GavinGY/MotorMF_AI/FAN_Test/Test.jpg

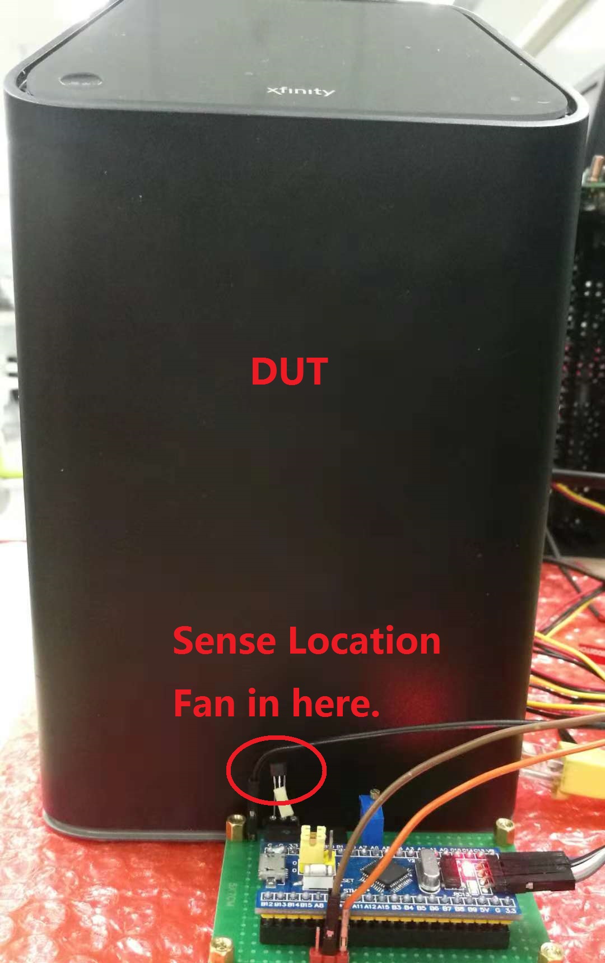
FAN_Test/Test.jpg
