GavinGY/MotorMF_AI/FAN_Test/Equipment.PNG

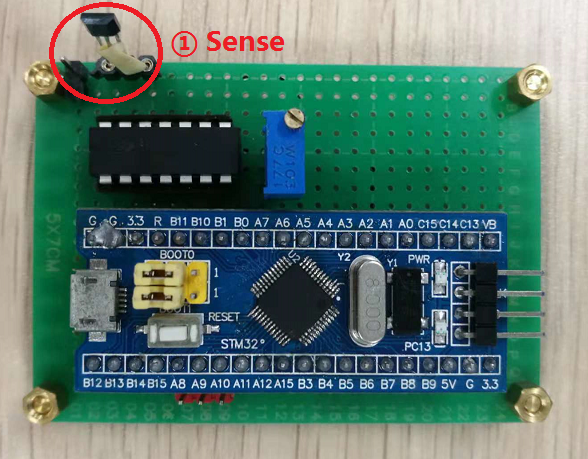
FAN_Test/Equipment.PNG
