GavinGY/MotorMF_AI/README.md

# MotorMF_AI
Motor magnetic field detection &amp;&amp; Edge of computing
