GavinGY/MotorMF_AI/FAN_Test/MagneticFieldDetection_BOM.xlsx

Comment | Description | Designator | Footprint | LibRef | Quantity | Value
Red LED | Typical INFRARED GaAs LED | D1 | LED-Red | LED | 1 | Red
AM3503 | Header, 3-Pin | P1 | HDR1X3 | AM3503 | 1 | AM3503
Power-IN | Header, 2-Pin | P2 | HDR1X2 | Header 2 | 1
UART | Header, 4-Pin, Right Angle | P3 | HDR1X4H | Header 4H | 1
Res Tap | Tapped Resistor | R1 | VR3 | Res Tap | 1 | 10K
Res Semi | Semiconductor Resistor | R2 | AXIAL-0.5 | Res Semi | 1 | 390R
Res Semi | Semiconductor Resistor | R3 | AXIAL-0.5 | Res Semi | 1 | 100K
Res Semi | Semiconductor Resistor | R4 | AXIAL-0.3 | Res1 | 1 | 510R
STM32F103C8T6_CoreBoard | MCU Core Board | U1 | DIP40 | STM32F103C8T6_CoreBoard | 1
LM324 | SOP-14/DIP-14 | U2 | LM324 | LM324 | 1
