GavinGY/MotorMF_AI/FAN_Test/FAN Fixture User Guide.pptx

XB6/XB7 FAN Test Fixture User Guide

By Foxconn RD Gavin Zhang

January 1st, 2019

## Slide 2

1.Download Firmware to Fan fixture
1.1 Install J-Link Drive
1.2 Fan Fixture and computer download mode hardware connection
1.3 Download Firmware to Fan fixture
2.Test Fan fixture Function
2.1 Fan Fixture and computer normal mode hardware connection
2.2 Install Fan Fixture Drive for Windows (If the computer doesn't recognize it properly )
2.3 Open COM port Test tools verify Fixture function

1

## Slide 3

1. Download Firmware to Fan fixture

## Slide 4

1.1 Install J-Link Drive

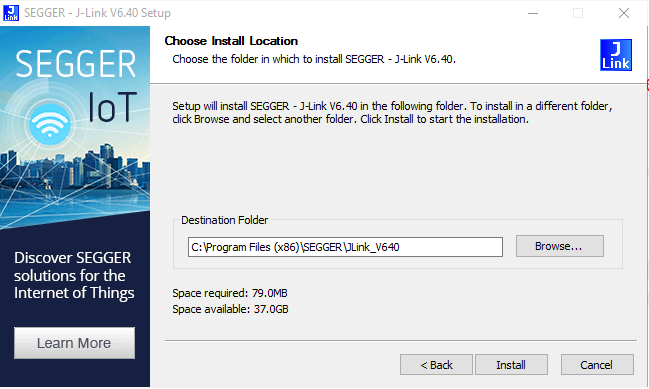
[picture p3: figure]

J-Link Software and Documentation pack for Windows32 bit: JLink_Windows_V640.exe

2

## Slide 5

1.2 Fan Fixture and computer download mode hardware connection

FAN Fixture
STM32 Core Board

VCC 3.3

J-link OB

PC - Windows

SWDIO

SWCLK

Micro-USB

USB Cable

Host-USB

GND

2

## Slide 6

1.3 Download Firmware to Fan fixture

1. Connect the HW cable
2. Open J-link tools location C:\ProgramData\Microsoft\Windows\Start Menu\Programs\SEGGER - J-Link V6.40
3. Launch the J-Flash Lite V6.40

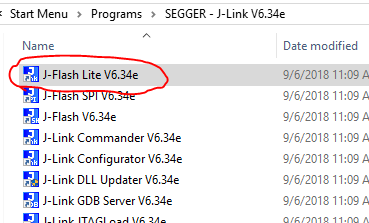
[picture p4: figure]

2

## Slide 7

4. Choose IC model

4.1Click More Button

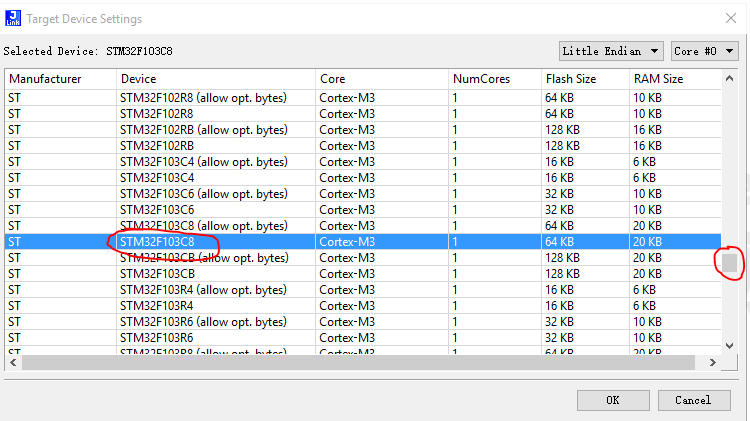
[picture p5: figure]

4.2 Select IC Item
“STM32F103C8T6”

4.3 Click OK Button

## Slide 8

5. Download Firmware

5.1 Click OK Button

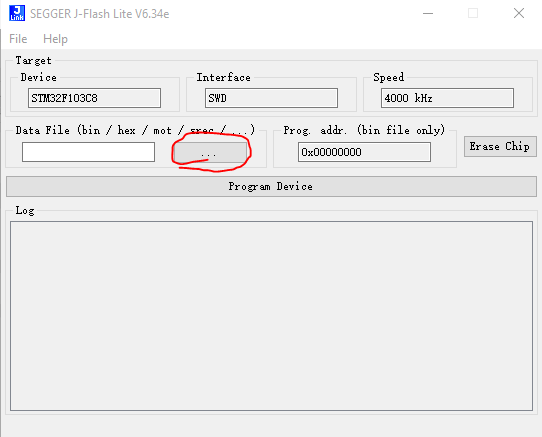
[picture p6: figure]

5.2 Click More Button

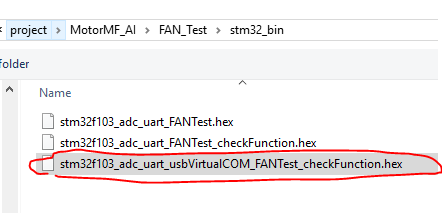
[picture p7: figure]

5.3 Select hex file
stm32f103_adc_uart_usbVirtualCOM_FANTest_checkFunction.hex

## Slide 9

5. Download Firmware

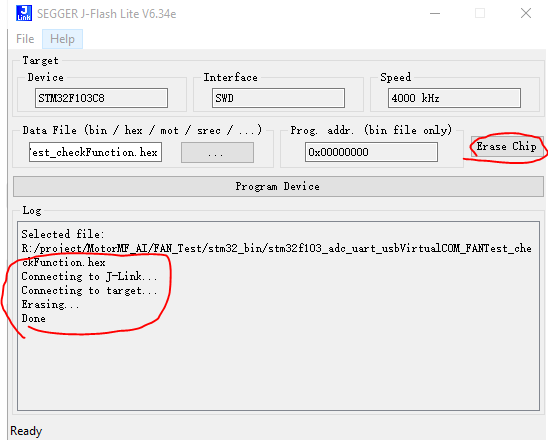
[picture p8: figure]

5.4 Click Erase Button

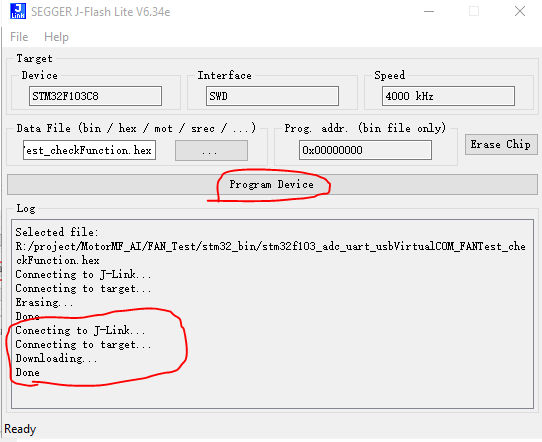
[picture p9: figure]

5.5 Click Program Device Button

5.6 If download OK, you can disconnect from your PC and close the J-link software.

## Slide 10

2. Test Fan fixture Function

## Slide 11

2.1 Fan Fixture and computer normal mode hardware connection

FAN Fixture
STM32 Core Board

PC - Windows

USB Cable

Micro-USB

Host-USB

## Slide 12

2.2 computer will automatically identify the driver
(If the computer doesn‘t recognize it properly, need install Fan Fixture Drive for Windows )

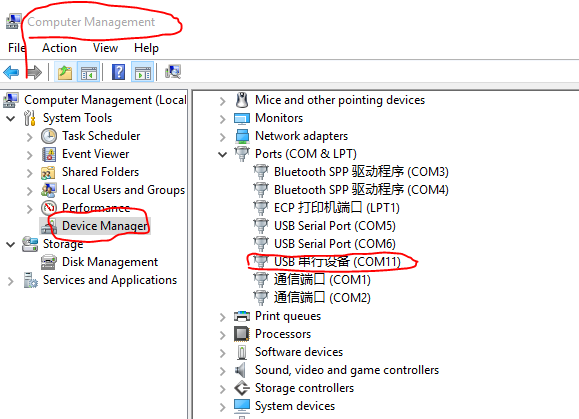
[picture p10: figure]

You can see that the computer has discovered new COM hardware devices

## Slide 13

2.3 Open COM port Test tools verify Fixture function

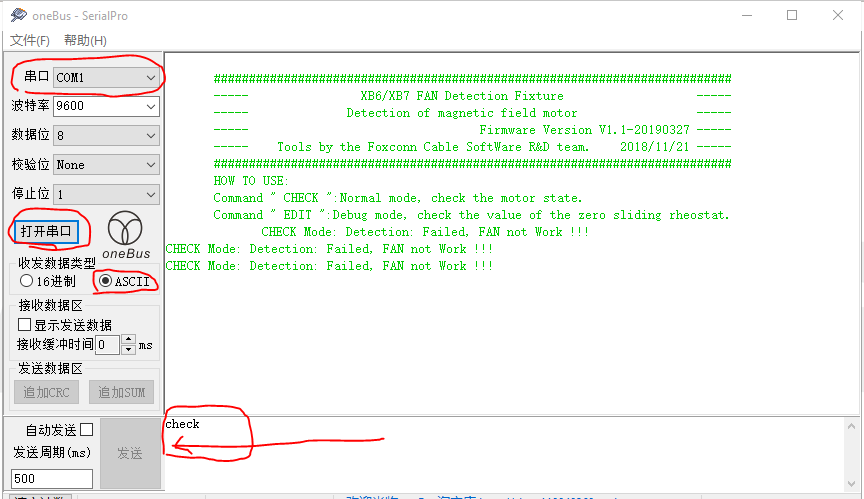
[picture p11: figure]

Press enter on the keyboard
