GavinGY/MotorMF_AI/FAN_Test/FAN_OFF_Failed.PNG

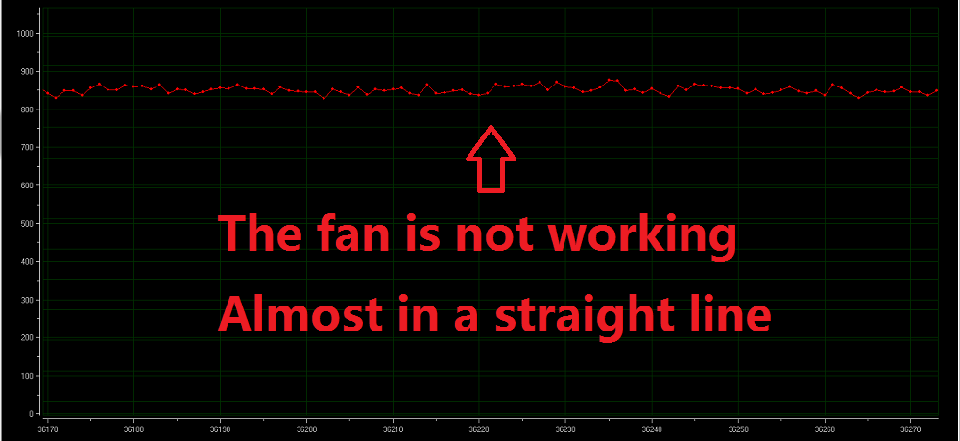
FAN_Test/FAN_OFF_Failed.PNG
