GavinGY/MotorMF_AI/FAN_Test/FAN_OK.PNG

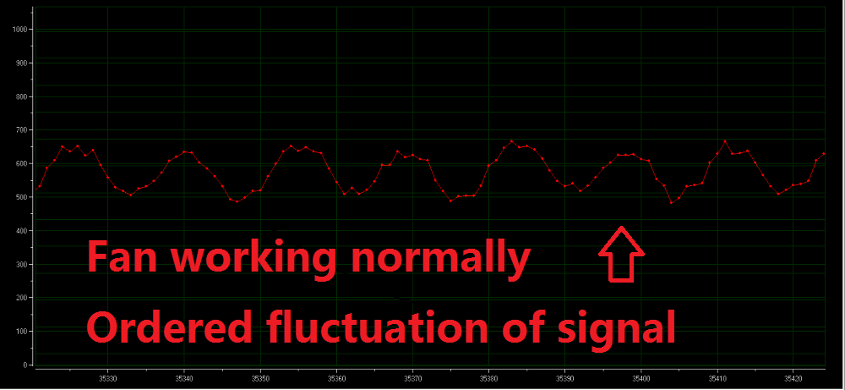
FAN_Test/FAN_OK.PNG
