GavinGY/MotorMF_AI/FAN_Test/FAN_Working.PNG

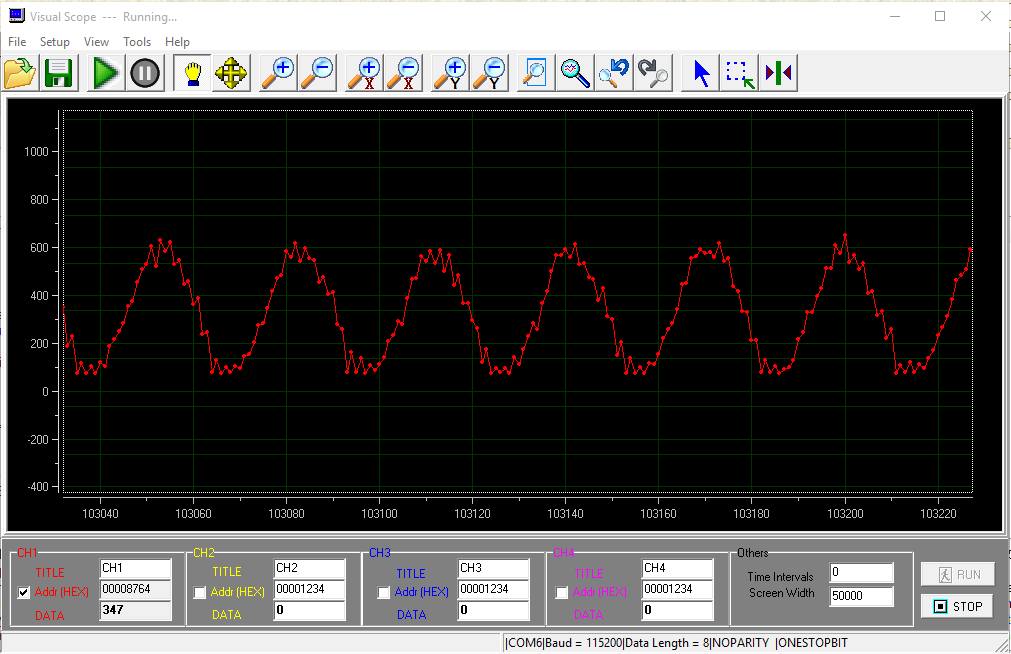
FAN_Test/FAN_Working.PNG
