GavinGY/MotorMF_AI/FAN_Test/HW.png

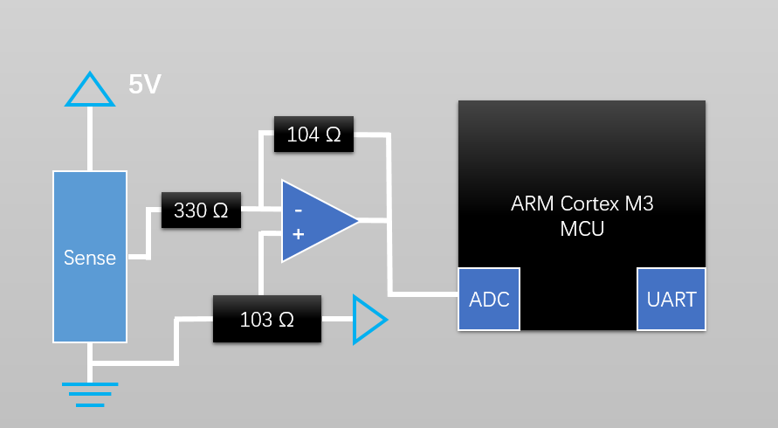
FAN_Test/HW.png
