GavinGY/MotorMF_AI/FAN_Test/SW.png

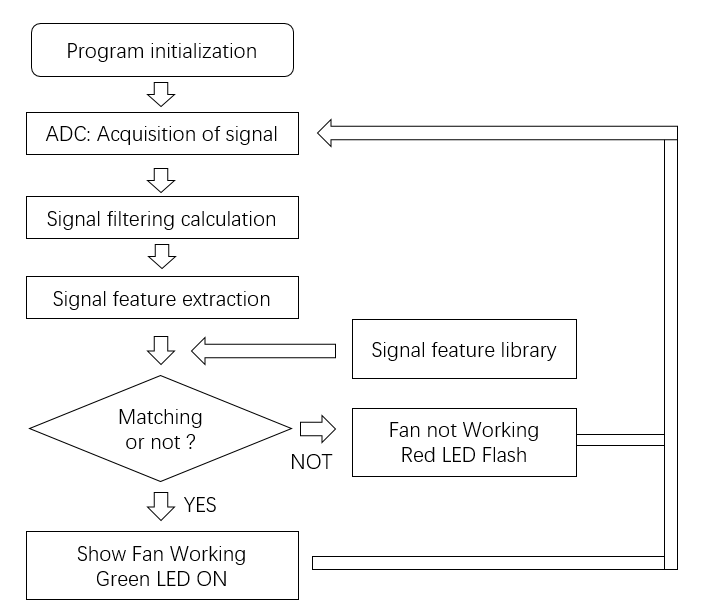
FAN_Test/SW.png
