GavinGY/MotorMF_AI/FAN_Test/MagneticFieldDetection_schematic.pdf

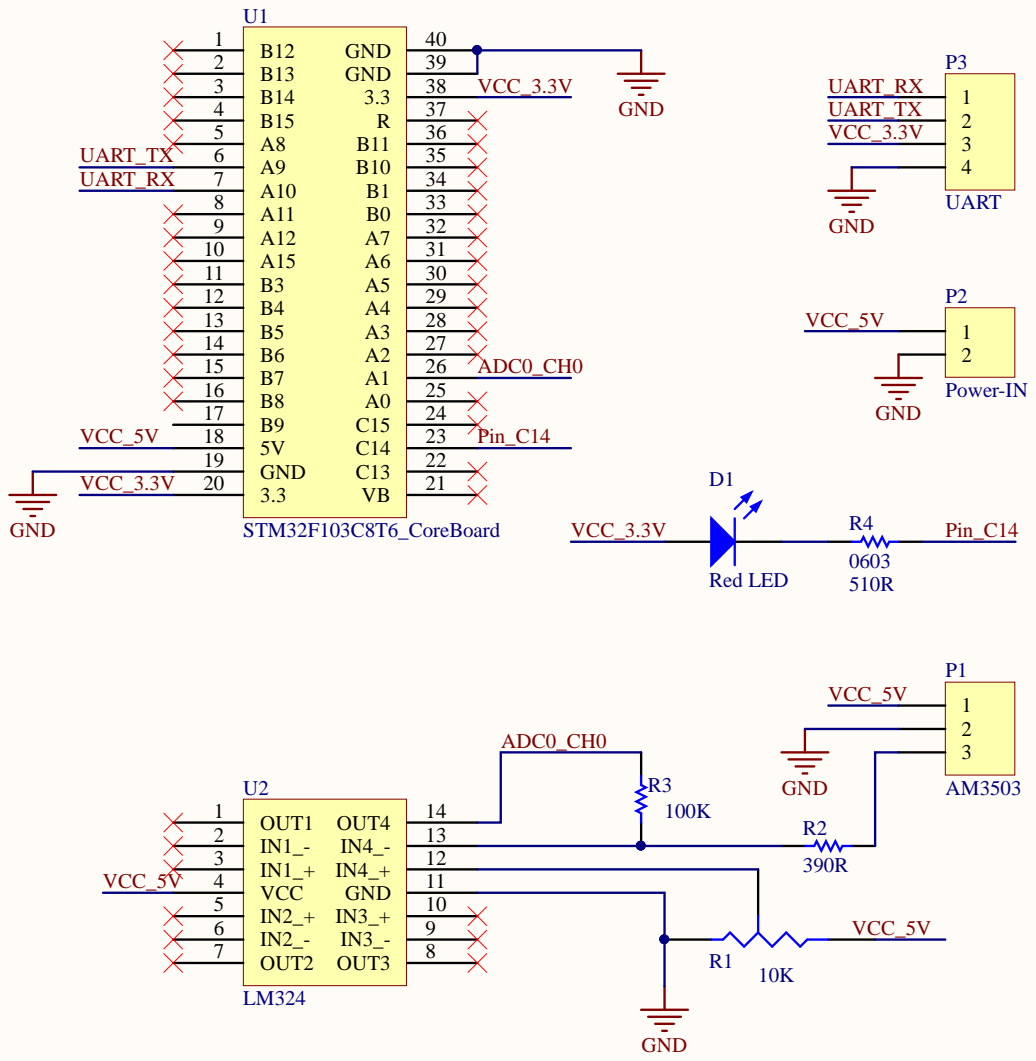
[picture p17: page 1]
