GavinGY/MotorMF_AI/(list of files, drawings)

Other design files:
PCB_Project/MagneticFieldDetection/MagneticFieldDetection.PcbDoc
PCB_Project/MagneticFieldDetection/MagneticFieldDetection.PrjPCB
PCB_Project/MagneticFieldDetection/MagneticFieldDetection.SchDoc
