GavinGY/MotorMF_AI/stm32_project/System/Inc/dma.h

#ifndef __DMA_H
#define __DMA_H
#include "sys.h"
//////////////////////////////////////////////////////////////////////////////////	 
//本程序只供学习使用，未经作者许可，不得用于其它任何用途
//ALIENTEK STM32F103开发板
//DMA驱动代码	   
//正点原子@ALIENTEK
//技术论坛:www.openedv.com
//创建日期:2017/5/29
//版本：V1.0
//版权所有，盗版必究。
//Copyright(C) 广州市星翼电子科技有限公司 2014-2024
//All rights reserved									  
////////////////////////////////////////////////////////////////////////////////// 	

extern DMA_HandleTypeDef  UART1TxDMA_Handler;      //DMA句柄

void MYDMA_UART_Config(DMA_Channel_TypeDef *chx);
void MYDMA_USART_Transmit(UART_HandleTypeDef *huart, uint8_t *pData, uint16_t Size);

#endif
