GavinGY/MotorMF_AI/(commit log)

2018-12-01 add init source code commit.
    [MagneticFieldDetection.PcbDoc, MagneticFieldDetection.PrjPCB, MagneticFieldDetection.SchDoc, MagneticFieldDetection_BOM.xlsx]
2019-02-27 Add uart and detection moto spin function.
2019-03-07 update stm32 usb drive name and tools
