GavinGY/MotorMF_AI/(notices)

Notices in the files:
stm32_projectUsbVirtualCOM/System/Src/led.c:
Copyright(C) ¹ãÖÝÊÐÐÇÒíµç×Ó¿Æ¼¼ÓÐÏÞ¹«Ë¾ 2014-2024
All rights reserved
stm32_projectUsbVirtualCOM/System/Inc/sys.h:
Copyright(C) ¹ãÖÝÊÐÐÇÒíµç×Ó¿Æ¼¼ÓÐÏÞ¹«Ë¾ 2009-2019
stm32_projectUsbVirtualCOM/System/Src/sys.c:
Copyright(C) ÕýµãÔ­×Ó 2009-2019
